lendres/Naquadah-Generator-Hardware/README.md

# Naquadah-Generator-Hardware
 Naquadah Generator hardware files.
