lendres/Naquadah-Generator-Hardware/User Interface Daughter Board/Notes.txt

Switch Options
https://www.digikey.com/product-detail/en/e-switch/200MSP1T5B7M2REH/200MSP1T5B7M2REH-ND/4027707
https://www.digikey.com/product-detail/en/e-switch/100SP3T1B1VS2REH/EG5755-ND/4027606

https://www.digikey.com/product-detail/en/e-switch/100SP1T1B1M3QEH/EG5748-ND/4027559

https://www.digikey.com/product-detail/en/apem-inc/MHPS2283/679-3532-ND/1795387
