lendres/Naquadah-Generator-Hardware/State Sensing Board/State Sensing Board.step

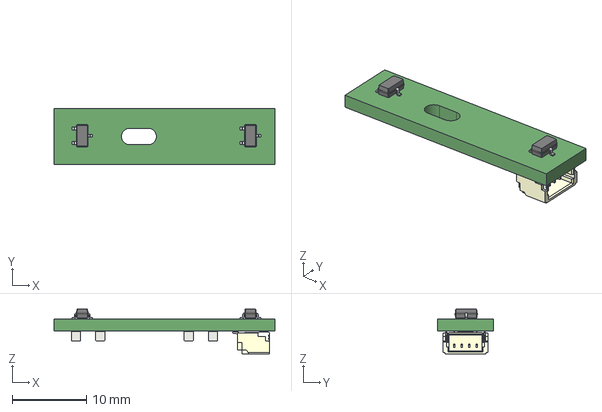
[picture p1: CAD file, 2020-05-26]
State Sensing Board/State Sensing Board.step
29.7 x 7.50 x 6.01 mm
