lendres/Naquadah-Generator-Hardware/User Interface Daughter Board/User Interface Daughter Board.kicad_pcb

## KiCad design User Interface Daughter Board/User Interface Daughter Board.kicad_pcb (2020-10-01)

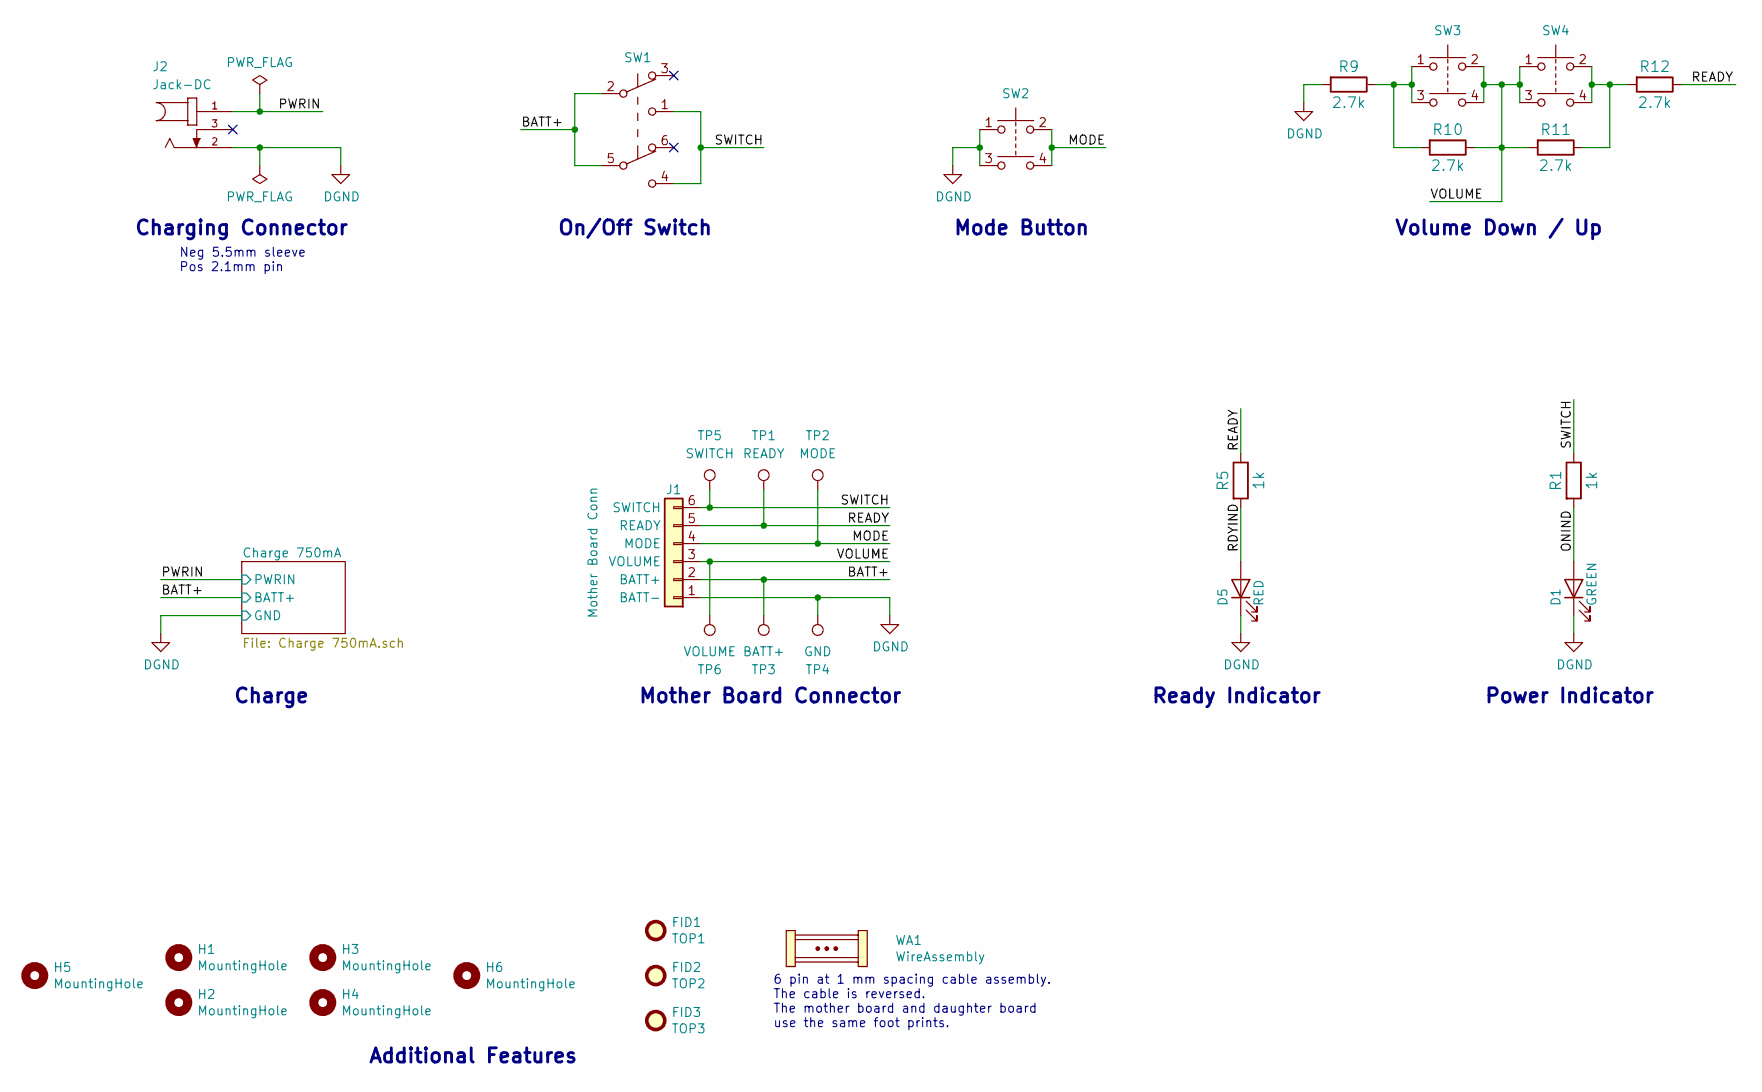
[picture p4: schematic User Interface Daughter Board.sch, Li-ion 5A Boost 1A Charge Protect]

Parts:
D1: GREEN; LED_0805_2012Metric; Manufacturer Part No. 150080VS75000
D5: RED; LED_0805_2012Metric; Manufacturer Part No. 150080RS75000
FID1, FID2, FID3: Fiducial; Fiducial_1mm_Mask2mm; Manufacturer Part No. None
H1, H2, H3, H4, H5, H6: MountingHole; MountingHole_2.7mm_M2.5; Manufacturer Part No. None
J1: Mother Board Conn; JST_SH_BM06B-SRSS-TB_1x06-1MP_P1.00mm_Vertical; Manufacturer Part No. BM04B-SRSS-TB(LF)(SN)
J2: Jack-DC; PJ-006A-SMT; Manufacturer Part No. PJ-006A-SMT-TR
R1, R5: 1k; 0805_2012Metric; Manufacturer Part No. RK73H2ATTD1001F
R9, R10, R11, R12: 2.7k; 0805_2012Metric; Manufacturer Part No. RK73H2ATTD2701F
SW1: SW_Push_DPDT_2-5_3-4_1-4; ESB-33535A; Manufacturer Part No. ESB-33535A
SW2, SW3, SW4: SW_Push_Dual_1-3_2-4; PTS647SK38SMTR2LFS; Manufacturer Part No. PTS 647 SN70 SMTR2 LFS
TP1, TP2, TP3, TP4, TP5, TP6: TestPoint; Pad_2.5-2.5; Manufacturer Part No. None
WA1: WireAssembly; Wire_Assembly; Manufacturer Part No. A06SR06SR30K305A

Connections:
/BATT+: J1.2 (BATT+), SW1.2 (C), SW1.5 (C), TP3.1; also elsewhere on the board
/MODE: J1.4 (MODE), SW2.2, SW2.4, TP2.1
/ONIND: D1.2 (A(P)), R1.2
/PWRIN: J2.1; also elsewhere on the board
/RDYIND: D5.2 (A(P)), R5.2
/READY: J1.5 (READY), R5.1, R12.1, TP1.1
/SWITCH: J1.6 (SWITCH), R1.1, SW1.1 (NO), SW1.4 (NO), TP5.1
/VOLUME: J1.3 (VOLUME), R10.1, R11.2, SW3.2, SW3.4, SW4.1, SW4.3, TP6.1
DGND: D1.1 (K(N)), D5.1 (K(N)), J1.1 (BATT-), J2.2, R9.2, SW2.1, SW2.3, TP4.1; also elsewhere on the board
unnamed: R9.1, R10.2, SW3.1, SW3.3
unnamed: R11.1, R12.2, SW4.2, SW4.4

Notes on the sheet:
Charging Connector
Neg 5.5mm sleeve Pos 2.1mm pin
Mother Board Connector
On/Off Switch
Power Indicator
Ready Indicator
Additional Features
Mode Button
Charge
Volume Down / Up
6 pin at 1 mm spacing cable assembly. The cable is reversed. The mother board and daughter board use the same foot prints.

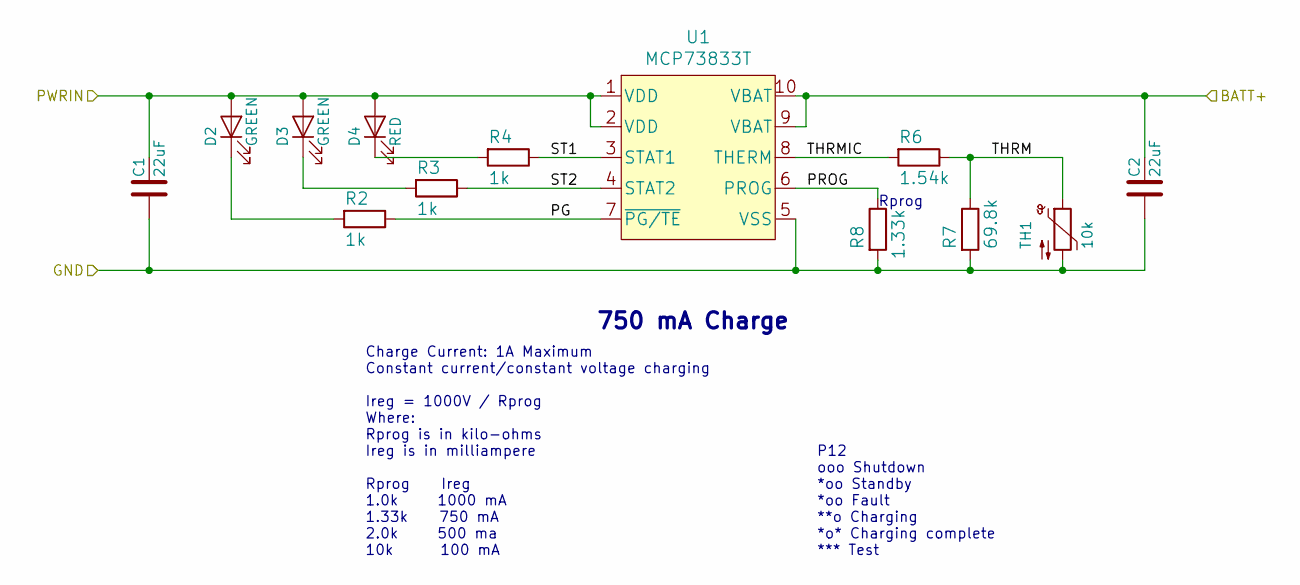
[picture p5: schematic Charge 750mA.sch, Li-ion 5A Boost 1A Charge Protect]

Parts:
C1, C2: 22uF; 0805_2012Metric; Manufacturer Part No. CL21A226KQCLRNC
D2, D3: GREEN; LED_0805_2012Metric; Manufacturer Part No. 150080VS75000
D4: RED; LED_0805_2012Metric; Manufacturer Part No. 150080RS75000
R2, R3, R4: 1k; 0805_2012Metric; Manufacturer Part No. RK73H2ATTD1001F
R6: 1.54k; 0805_2012Metric; Manufacturer Part No. RK73H2ATTD1541F
R7: 69.8k; 0805_2012Metric; Manufacturer Part No. RK73H2ATTD6982F
R8: 1.33k; 0805_2012Metric; Manufacturer Part No. RK73H2ATTD1331F
TH1: 10k; 0805_2012Metric; Manufacturer Part No. NTCG203NH103JT1
U1: MCP73833T; MCP73833; Manufacturer Part No. MCP73833T-AMI/UN

Connections:
/BATT+: C2.1, U1.9 (VBAT), U1.10 (VBAT); also elsewhere on the board
/Charge 750mA/PG: R2.1, U1.7 (~PG/TE)
/Charge 750mA/PROG: R8.1, U1.6 (PROG)
/Charge 750mA/ST1: R4.1, U1.3 (STAT1)
/Charge 750mA/ST2: R3.1, U1.4 (STAT2)
/Charge 750mA/THRM: R6.1, R7.1, TH1.1
/Charge 750mA/THRMIC: R6.2, U1.8 (THERM)
/PWRIN: C1.1, D2.2 (A(P)), D3.2 (A(P)), D4.2 (A(P)), U1.1 (VDD), U1.2 (VDD); also elsewhere on the board
DGND: C1.2, C2.2, R7.2, R8.2, TH1.2, U1.5 (VSS); also elsewhere on the board
unnamed: D2.1 (K(N)), R2.2
unnamed: D3.1 (K(N)), R3.2
unnamed: D4.1 (K(N)), R4.2

Notes on the sheet:
750 mA Charge
Charge Current: 1A Maximum Constant current/constant voltage charging Ireg = 1000V / Rprog Where: Rprog is in kilo-ohms Ireg is in milliampere Rprog Ireg 1.0k 1000 mA 1.33k 750 mA 2.0k 500 ma 10k 100 mA
Rprog
P12 ooo Shutdown *oo Standby *oo Fault **o Charging *o* Charging complete *** Test

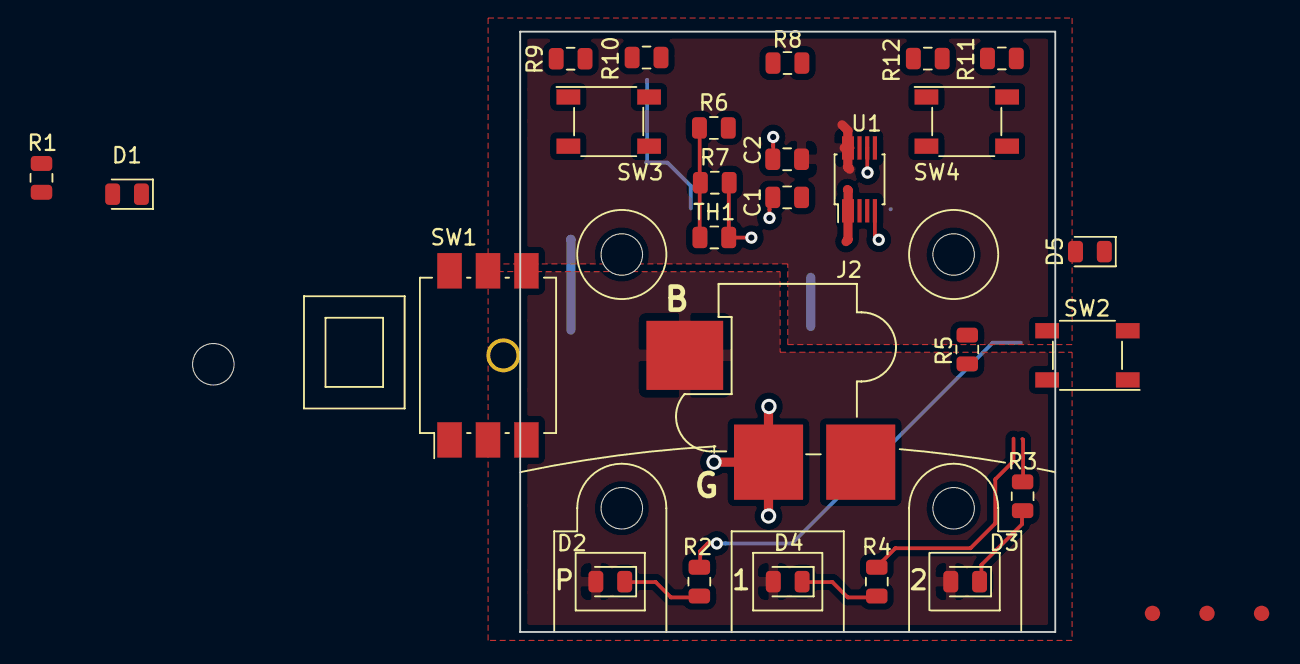
[picture p6: board User Interface Daughter Board.kicad_pcb from above]

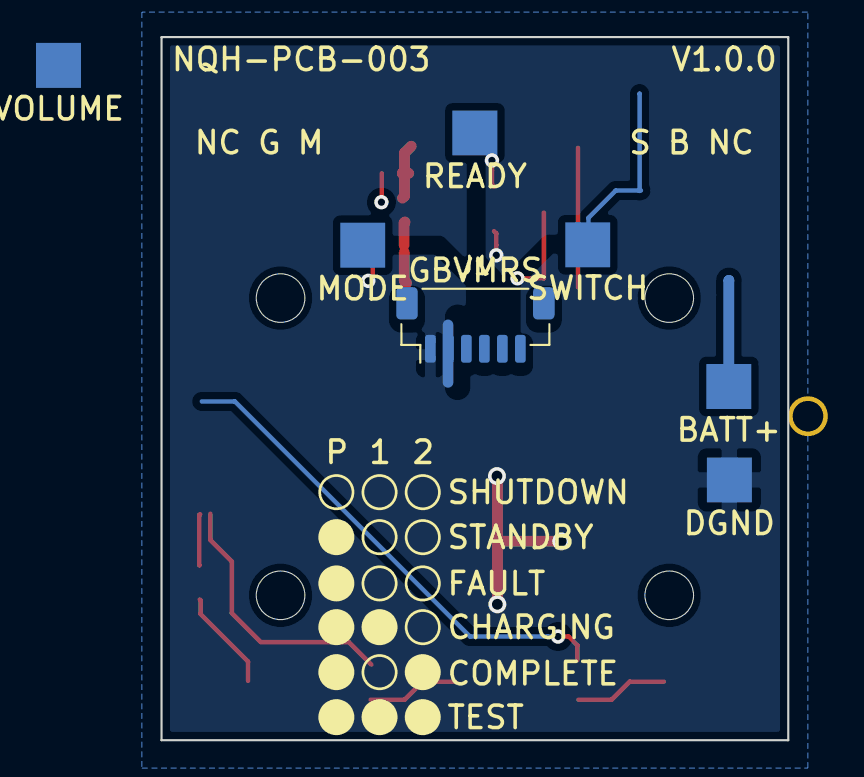
[picture p7: board User Interface Daughter Board.kicad_pcb from below]

Board: 2 copper layers, 34.8 x 39.1 mm, 43 parts (7 on the bottom side), 20 nets.
