lendres/Naquadah-Generator-Hardware/State Sensing Board/State Sensing Board.kicad_pcb

## KiCad design State Sensing Board/State Sensing Board.kicad_pcb (2020-10-01)

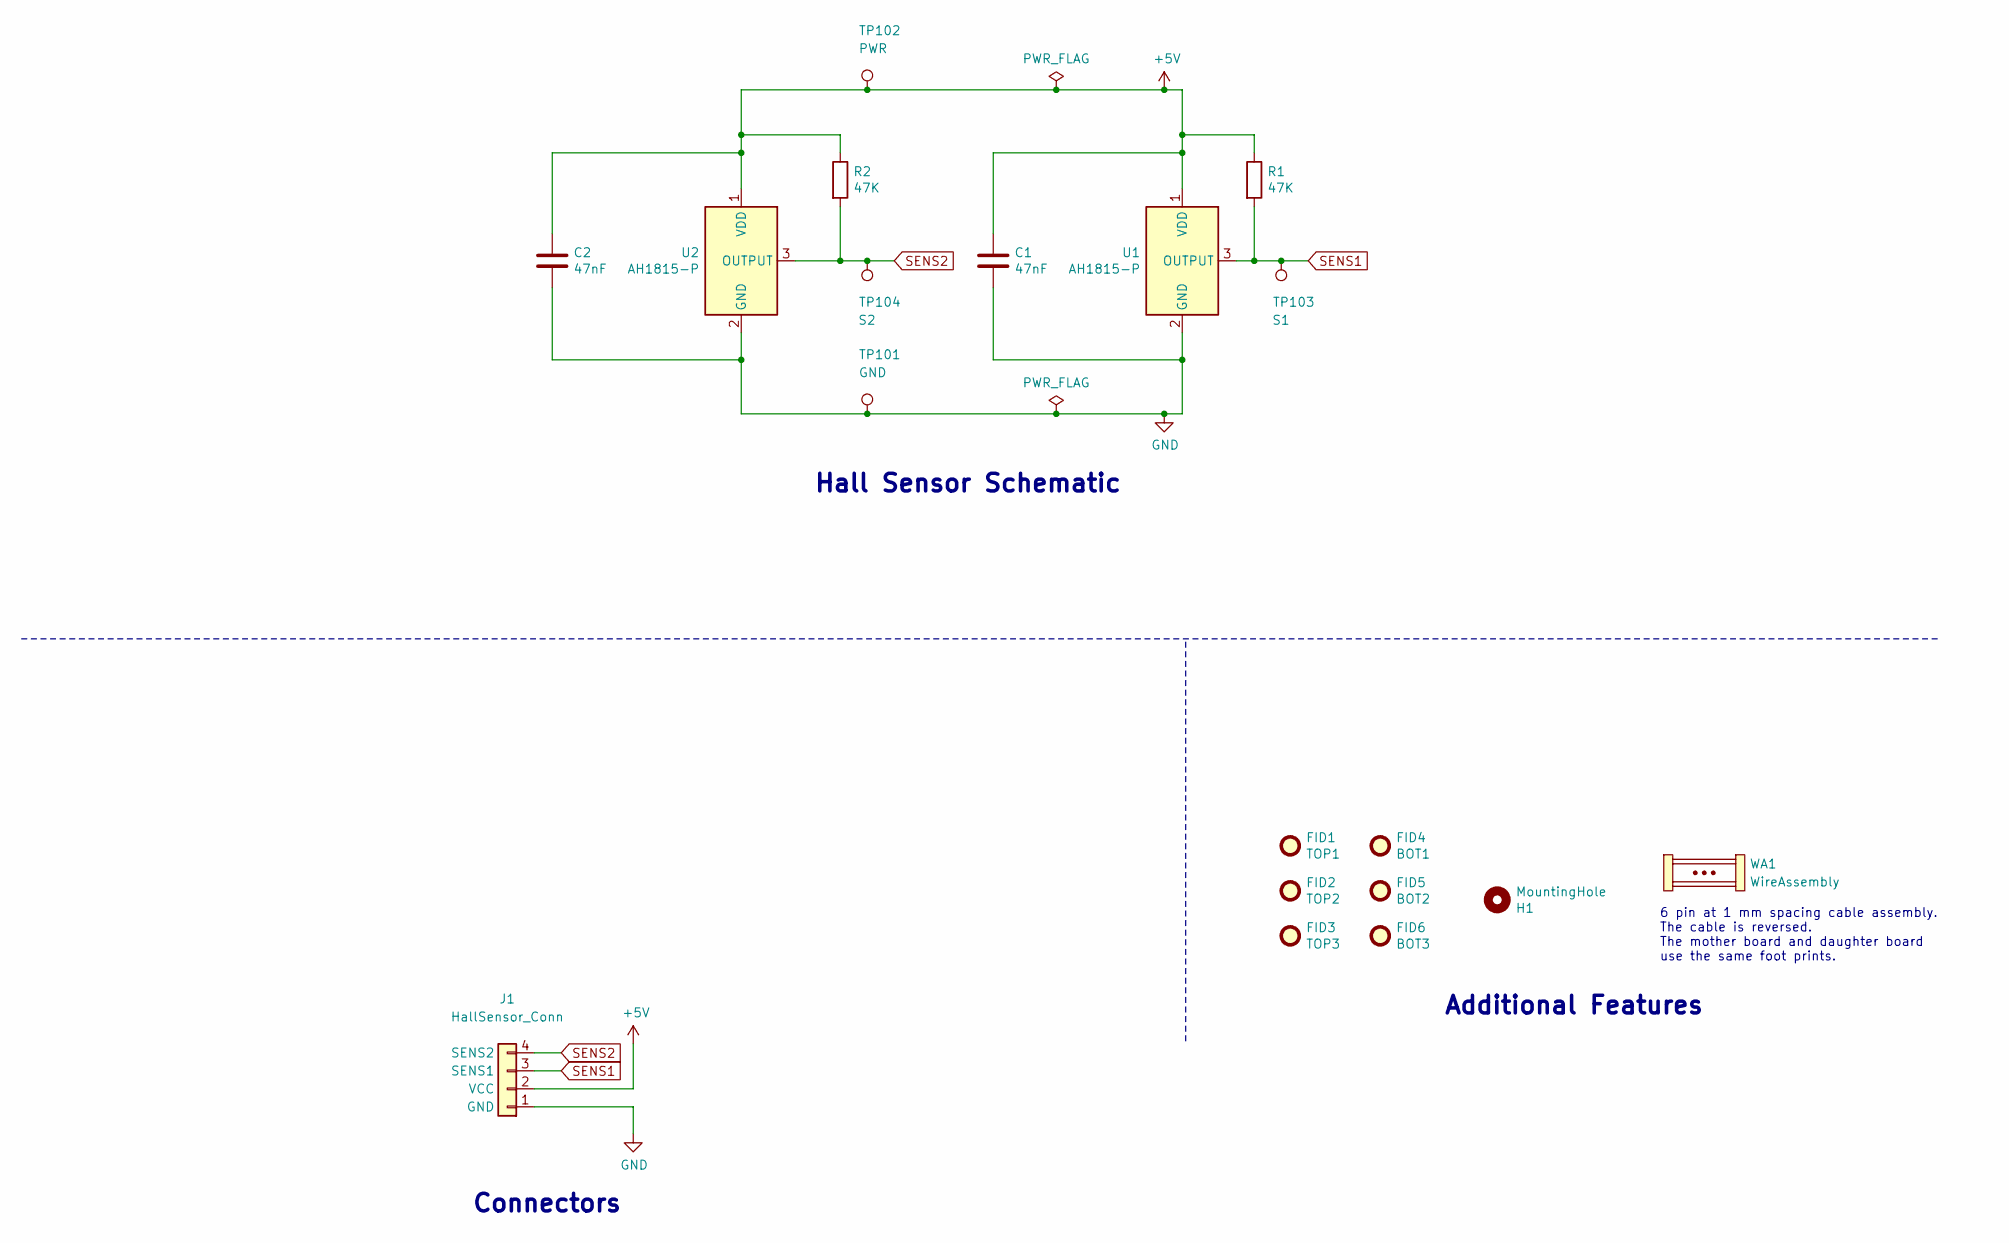
[picture p8: schematic State Sensing Board.sch]

Parts:
C1, C2: 47nF; 0805_2012Metric_HandSolder; Manufacturer Part No. CL21B473KBANNNC
FID1, FID2, FID3, FID4, FID5, FID6: Fiducial; Fiducial_0.5mm_Mask1mm; Manufacturer Part No. None
H1: MountingHole; MountingSlot_2.2mm_2.2mm_M2.0; Manufacturer Part No. None
J1: HallSensor_Conn; JST_SH_SM04B-SRSS-TB_1x04-1MP_P1.00mm_Horizontal; Manufacturer Part No. SM04B-SRSS-TB(LF)(SN)
R1, R29: 47K; 0805_2012Metric_HandSolder; Manufacturer Part No. RK73H2ATTD4702F
TP101, TP102, TP103, TP104: TestPoint_1; Pad_1.25-1.25; Manufacturer Part No. None
U1, U2: AH1815-P; SC-59_Hall_Sensor_Handsoldering; Manufacturer Part No. AH1815-W-7
WA1: WireAssembly; Wire_Assembly; Manufacturer Part No. A04SR04SR30K152A

Connections:
+5V: C1.1, C2.1, J1.2 (VCC), R1.1, TP102.1, U1.1 (VDD), U2.1 (VDD); also elsewhere on the board
GND: C1.2, C2.2, J1.1 (GND), TP101.1, U1.2 (GND), U2.2 (GND)
SENS1: J1.3 (SENS1), R1.2, TP103.1, U1.3 (OUTPUT)
SENS2: J1.4 (SENS2), TP104.1, U2.3 (OUTPUT); also elsewhere on the board

Notes on the sheet:
Hall Sensor Schematic
Connectors
Additional Features
6 pin at 1 mm spacing cable assembly. The cable is reversed. The mother board and daughter board use the same foot prints.

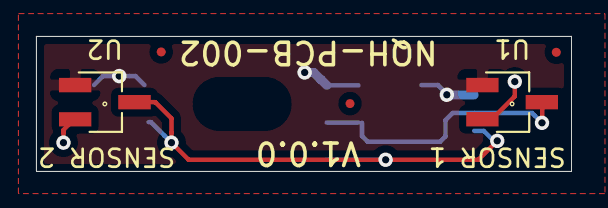
[picture p9: board State Sensing Board.kicad_pcb from above]

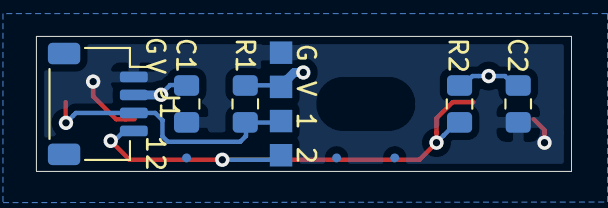
[picture p10: board State Sensing Board.kicad_pcb from below]

Board: 2 copper layers, 29.7 x 7.5 mm, 19 parts (12 on the bottom side), 4 nets.

Other parts of the board:
R2: 47K; 0805_2012Metric_HandSolder

Their connections:
+5V: R2.1; also elsewhere on the board
SENS2: R2.2; also elsewhere on the board
