lendres/Naquadah-Generator-Hardware/(commit log)

2020-04-23 Update State Sensing Board.kicad_pcb
    [State Sensing Board.kicad_pcb]
2020-04-26 Update hall sensor board.
    [State Sensing Board.kicad_pcb, State Sensing Board.sch]
2020-04-26 Update component values
    [State Sensing Board-2.sch, State Sensing Board.kicad_pcb, State Sensing Board.sch]
2020-04-27 State sensing board revisions
    Moved everything except hall sensors to back of state sensing board.
    [State Sensing Board.kicad_pcb, State Sensing Board.sch]
2020-04-27 Updates to State Sensing Board
    [State Sensing Board.kicad_pcb, State Sensing Board.sch]
2020-05-09 Before changing BOM
    [BlueLights.sch, GreenRedLights.sch, Li-ion 5A Boost 1A Charge Protect.kicad_pcb, Li-ion 5A Boost 1A Charge Protect.sch, Naquadah Generator Main.kicad_pcb, Naquadah Generator Main.sch, Power.sch, State Sensing Board.kicad_pcb]
2020-05-09 Updates before converting to 0805_2012
    [Li-ion 5A Boost 1A Charge Protect.kicad_pcb, Li-ion 5A Boost 1A Charge Protect.sch]
2020-05-10 Moved Li-Ion Libraries
    [Li-ion 5A Boost 1A Charge Protect.kicad_pcb, Li-ion 5A Boost 1A Charge Protect.sch]
2020-05-10 Start of PCB Layout
    [Li-ion 5A Boost 1A Charge Protect.kicad_pcb, Li-ion 5A Boost 1A Charge Protect.sch]
2020-05-10 Preliminary PCB layout 1
    [Li-ion 5A Boost 1A Charge Protect.kicad_pcb, Li-ion 5A Boost 1A Charge Protect.sch]
2020-05-11 Updates to PCB
    [Li-ion 5A Boost 1A Charge Protect.kicad_pcb]
2020-05-11 PCB Updates
    [Li-ion 5A Boost 1A Charge Protect.kicad_pcb]
2020-05-11 Updated diode footprint
    [Li-ion 5A Boost 1A Charge Protect.kicad_pcb]
2020-05-11 Updates to Boost out on PCB
    [Li-ion 5A Boost 1A Charge Protect.kicad_pcb, Li-ion 5A Boost 1A Charge Protect.sch]
2020-05-11 PCB Update
    [Li-ion 5A Boost 1A Charge Protect.kicad_pcb, Li-ion 5A Boost 1A Charge Protect.sch]
2020-05-11 Update Li-ion 5A Boost 1A Charge Protect.kicad_pcb
    [Li-ion 5A Boost 1A Charge Protect.kicad_pcb]
2020-05-12 PCB Update
    Working layout with repositioned charge and protect sections. Still work to be done on labeling, 3D models, and copper pours on bottom.
    [Li-ion 5A Boost 1A Charge Protect.kicad_pcb, Li-ion 5A Boost 1A Charge Protect.sch]
2020-05-12 PCB Before Solder Footprint Switch
    Before switching wire solder points to foot prints with through holes.
    [Li-ion 5A Boost 1A Charge Protect.kicad_pcb, Li-ion 5A Boost 1A Charge Protect.sch]
2020-05-12 PCB Update, back silk screen
    [Li-ion 5A Boost 1A Charge Protect.kicad_pcb]
2020-05-13 PCB and 3D model updates
    [Li-ion 5A Boost 1A Charge Protect.kicad_pcb, Li-ion 5A Boost 1A Charge Protect.sch]
2020-05-13 PCB Cleanup and corrections
    [Li-ion 5A Boost 1A Charge Protect.kicad_pcb, Li-ion 5A Boost 1A Charge Protect.sch]
2020-05-13 PCB Tweaks
    [Li-ion 5A Boost 1A Charge Protect.kicad_pcb]
2020-05-15 Version 1.0.0
    Version 1.0.0
    [Li-ion 5A Boost 1A Charge Protect.kicad_pcb, Li-ion 5A Boost 1A Charge Protect.xlsx]
2020-05-19 Changed name of libraries to remove underscore
    [BlueLights.sch, GreenRedLights.sch, Li-ion 5A Boost 1A Charge Protect.sch, Naquadah Generator Main.sch, Power.sch, Shift Registers.sch, State Sensing Board - Copy.sch, State Sensing Board.kicad_pcb]
2020-05-20 Partial Update
    [BlueLights.sch, GreenRedLights.sch, Li-ion 5A Boost 1A Charge Protect.sch, Naquadah Generator Main.kicad_pcb, Naquadah Generator Main.sch, Power.sch, Shift Registers.sch, State Sensing Board.kicad_pcb]
2020-05-26 Resize to correct for scale
    [BlueLights.sch, GreenRedLights.sch, Naquadah Generator Main.kicad_pcb, Naquadah Generator Main.sch, Power.sch, Shift Registers.sch, State Sensing Board - Copy.sch, State Sensing Board.kicad_pcb]
2020-05-26 Size corrections and other PCB prep
    [PCB Insert Drawing v1 Sheet1.dwg, PCB Insert Drawing v1 Sheet1.dxf, PCB Insert Drawing v1.dwg, PCB Insert Drawing v2 Sheet1.dwg, PCB Insert Drawing v2 Sheet1.dxf, State Sensing Board.kicad_pcb, State Sensing Board.step]
2020-05-29 Updates to PCB Mount
    [GreenRedLights.sch, Li-ion 5A Boost 1A Charge Protect.kicad_pcb, Naquadah Generator Main.kicad_pcb, Naquadah Generator Main.sch, PCB Insert Drawing v2 Sheet1.dxf, State Sensing Board.kicad_pcb, State Sensing Board.sch]
2020-05-30 Library Updates
    [GreenRedLights.sch, Naquadah Generator Main.kicad_pcb, Naquadah Generator Main.sch]
2020-05-31 Added real power schematic
    [Connectors.sch, Naquadah Generator Main.kicad_pcb, Power.sch]
2020-05-31 Symbol field corrections and additions
    [Connectors.sch, Li-ion 5A Boost 1A Charge Protect.sch, Naquadah Generator Main.sch, Power.sch]
2020-06-06 Adding Power Daughter Board
    [BlueLights.sch, Connectors.sch, Li-ion 5A Boost 1A Charge Protect.kicad_pcb, Li-ion 5A Boost 1A Charge Protect.sch, Naquadah Generator Main.kicad_pcb, Naquadah Generator Main.sch, Power Daughter Board.kicad_pcb, Power Daughter Board.sch]
2020-06-06 PCB preliminary version
    [Power Daughter Board.kicad_pcb, Power Daughter Board.sch, Power Daughter Board.step, State Sensing Board.sch]
2020-06-06 Changer power daughter board directory name
    [Power Daughter Board.kicad_pcb, Power Daughter Board.sch, Power Daughter Board.step]
2020-06-07 Clean up
    [Power Daughter Board.kicad_pcb, Power Daughter Board.sch, Power.sch]
2020-06-08 Switched to 4 pin power board connector
    [Power Daughter Board.kicad_pcb, Power Daughter Board.sch, Power.sch, State Sensing Board.sch]
2020-06-08 Before updating to two switches
    [BlueLights.sch, Connectors.sch, Naquadah Generator Main.kicad_pcb, Naquadah Generator Main.sch, Power Daughter Board.kicad_pcb, Power Daughter Board.sch, Power.sch]
2020-06-09 Power board 2 switch V1
    [Power Daughter Board.kicad_pcb, Power Daughter Board.sch, Power Daughter Board.step, State Sensing Board.kicad_pcb]
2020-06-14 Move libraries and added configuration path.
    Moved Li-Ion library to common KiCad library. Added variables to configuration paths to reference my KiCad libraries. Moved all 3D components to my common library.
    [BlueLights.sch, Connectors.sch, GreenRedLights.sch, Li-ion 5A Boost 1A Charge Protect.kicad_pcb, Li-ion 5A Boost 1A Charge Protect.sch, Li-ion 5A Boost 1A Charge Protect.xlsx, Naquadah Generator Main.kicad_pcb, Naquadah Generator Main.sch]
2020-08-01 Start of audio
    [Audio.sch, BlueLights.sch, Naquadah Generator Main.sch, Power Daughter Board.kicad_pcb]
2020-08-03 Separated digital and analog ground.
    [Audio.sch, Connectors.sch, Naquadah Generator Main.sch, Power.sch, Shift Registers.sch, WhiteLights.sch]
2020-08-15 Audio update
    [Audio.sch, BlueLights.sch, Connectors.sch, GreenRedLights.sch, Naquadah Generator Main.kicad_pcb, Naquadah Generator Main.sch, Power Daughter Board.sch, Power.sch]
2020-08-20 Power updates
    [Audio.sch, BlueLights.sch, Boost 3.0A 5V 0805_2012.kicad_pcb, Boost 3.0A 5V 0805_2012.sch, Buck 3.3V 0603_1608.kicad_pcb, Buck 3.3V 0603_1608.sch, Buck 5V 0603_1608.kicad_pcb, Buck 5V 0603_1608.sch]
2020-08-20 Fixed analog and digital power symbol names.
    [Audio.sch, Naquadah Generator Main.kicad_pcb]
2020-08-22 Before switching buttons on daughter board
    [Audio.sch, BlueLights.sch, Charge 1.0A 0805_2012.sch, Charge 750mA 0805_2012.sch, Charge 750mA.sch, GreenRedLights.sch, Naquadah Generator Main.kicad_pcb, Power Daughter Board.kicad_pcb]
2020-08-24 Audio updates, switching to separate USB schematic
    Audio updates, switching to separate USB schematic
    [Audio.sch, BlueLights.sch, Boost 3.0A 5V 0805_2012.sch, Buck 3.3V 0603_1608.sch, Connector USB.sch, Connectors.sch, GreenRedLights.sch, Naquadah Generator Main.sch]
2020-08-26 Added level shifter, moved user interface connector location
    Added level shifter, moved user interface connector location
    [Audio.sch, BlueLights.sch, Boost 3.0A 5V 0805_2012.sch, Buck 3.3V 0603_1608.sch, Connector USB.sch, Connectors.sch, GreenRedLights.sch, Naquadah Generator Main.kicad_pcb]
2020-08-29 Switched to 0603_1608M size for passives
    [Audio.sch, BlueLights.sch, Boost 3.0A 5V 0805_2012.sch, Buck 3.3V 0603_1608.sch, Connector USB.sch, Connectors.sch, GreenRedLights.sch, Mono Amplifier PAM8302A.kicad_pcb]
2020-08-29 Removed schematic templates, Added audio connection
    Removed schematic templates, Added audio connection
    [Audio.sch, Boost 3.0A 5V 0805_2012.kicad_pcb, Boost 3.0A 5V 0805_2012.sch, Buck 3.3V 0603_1608.kicad_pcb, Buck 3.3V 0603_1608.sch, Buck 5V 0603_1608.kicad_pcb, Buck 5V 0603_1608.sch, Charge 1.0A 0805_2012.kicad_pcb]
2020-08-29 Rename daughter board to User Interface
    [Charge 750mA.sch, Power Daughter Board.step, User Interface Daughter Board.kicad_pcb, User Interface Daughter Board.sch]
2020-08-30 Update JST connectors
    [Audio.sch, Connector USB.sch, Connectors.sch, Naquadah Generator Main.kicad_pcb, Shift Registers.sch, State Sensing Board.kicad_pcb, State Sensing Board.sch, User Interface Daughter Board.kicad_pcb]
2020-09-03 Clean up of audio page
    [Audio.sch, Naquadah Generator Main.kicad_pcb]
2020-10-01 Updated fiducials.
    [Charge 750mA.sch, Naquadah Generator Main.kicad_pcb, Naquadah Generator Main.sch, State Sensing Board.kicad_pcb, State Sensing Board.sch, User Interface Daughter Board.kicad_pcb, User Interface Daughter Board.sch]
